COURS-YNOV/Projet-2-Carte-de-developpement-ESP32/Altium/ESP32_Project/com_.rtf

https://www.mouser.fr/datasheet/2/268/MCHP_S_A0010728890_1-2521060.pdf

MCP73831T-3ACI/OT
579-MCP73831T-3ACIOT

https://www.mouser.fr/ProductDetail/Microchip-Technology/MCP73831T-3ACI-OT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

—————————————————————————————————

https://www.digikey.fr/en/products/detail/CP2104-F03-GM/336-2008-5-ND/2486177?curr=usd
CP2104-F03-GM

—————————————————————————————————

https://www.mouser.fr/ProductDetail/AP-Memory/APS1604M-3SQR-SN?qs=IS%252B4QmGtzzpULD7HVv5Qww%3D%3D

PSRAM
