COURS-YNOV/Projet-2-Carte-de-developpement-ESP32/Altium/ESP32_Project/Project Outputs for ESP32_Projet/ESP32_Projet.xlsx

PN | Description | Comment | Designator | Fabricant | PN_Fab | Package | Footprint | Qualif | Temp | Tol | Volt | Puissance | Quantity | Lien
not use | Antennes Compact Reach Xtend 2.4 GHz | NN01-102 | B200 | Ignion | NN01-102 |  |  |  |  |  |  |  | 1 | https://www.mouser.fr/ProductDetail/Ignion/NN01-102?qs=bAKSY%2FctAC74AFavC%252BjOHQ%3D%3D
not use | Capacitor | 1uF | C100, C102, C104, C107, C201, C203, C204 | Murata Electronics | GRM155R61E105MA12D | 0402 |  |  |  | 20% |  |  | 7 | https://www.mouser.fr/ProductDetail/Murata-Electronics/GRM155R61E105MA12D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
not use | Capacitor | 0.1uF | C101, C103, C110 | Murata Electronics | GRM155R61C104KA88J | 0402 |  |  |  | 10% |  |  | 3 | https://www.mouser.fr/ProductDetail/Murata-Electronics/GRM155R61C104KA88J?qs=EsazKz6kkP2%252B3xHQUDEZoQ%3D%3D
not use | Capacitor | 1nF | C105 | Murata Electronics | GRT1555C1H102FA02D | 0402 |  |  |  | 1% |  |  | 1 | https://www.mouser.fr/ProductDetail/Murata-Electronics/GRT1555C1H102FA02D?qs=hd1VzrDQEGi3r1G6fgepQQ%3D%3D
not use | Capacitor | 4.7uF | C106, C200, C202 | Murata Electronics | GRT155D70J475ME13J | 0402 |  |  |  | 20% |  |  | 3 | https://www.mouser.fr/ProductDetail/Murata-Electronics/GRT155D70J475ME13J?qs=ufv2HEpFn%252BTkPthWI9s3Gg%3D%3D
not use | Capacitor | 1.2pF | C108 | Murata Electronics | GRM1555C1E1R2CA01D | 0402 |  |  |  | 0.25 pF |  |  | 1 | https://www.mouser.fr/ProductDetail/Murata-Electronics/GRM1555C1E1R2CA01D?qs=ouTquLLW2S4mMqEzAZk5RA%3D%3D
not use | Capacitor | 1.5pF | C109 | Murata Electronics | GRM1555C1H1R5BA01D | 0402 |  |  |  | 0.1 pF |  |  | 1 | https://www.mouser.fr/ProductDetail/Murata-Electronics/GRM1555C1H1R5BA01D?qs=ouTquLLW2S54hC6WW3CPAw%3D%3D
not use | Red, Green, Blue (RGB) 624nm Red, 525nm Green, 470nm Blue LED Indication - Discrete 2V Red, 3.3V Green, 3.3V Blue 4-SMD, No Lead | 150121M153000 | D200 | Wurth Elektronik | 150121M153000 | 0805 (2012 metric) |  |  |  |  |  |  | 1 | https://www.mouser.fr/ProductDetail/Wurth-Elektronik/150121M153000?qs=5aG0NVq1C4yYowchNNQhtg%3D%3D
not use | TVS Diode Array WE-TVS, High Speed Series - Low capazity - No leakage current - Low clamping voltage - high ESD voltage protection -- USB 1.0 - 2.0 | 824011 | D201 | Wurth Elektronik | 824011 | SOT-23-5 |  |  |  |  |  |  | 1 | https://www.mouser.fr/ProductDetail/Wurth-Elektronik/824011?qs=Wn16VcyqZWrHR48Vn%2FB8%252Bg%3D%3D
not use | Diode Array 3 Independent Schottky 40V 175mA Surface Mount 6-TSSOP, SC-88, SOT-363 | SD103AWS-7-F | DARR200 | Diodes Incorporated | SD103AWS-7-F | SOD-323-2 |  |  |  |  |  |  | 1 | https://www.mouser.fr/ProductDetail/Diodes-Incorporated/SD103AWS-7-F?qs=yDXQ%2Fb33kn1tCz%252Bb09bzhg%3D%3D
not use | Connecteurs USB USB Type C, 2.0, Rec, TH , G/F, RA , Top Mnt, T & R | USB4085-GF-A | J200 | GCT | USB4085-GF-A | 0402 |  |  |  |  |  |  | 1 | https://www.mouser.fr/ProductDetail/GCT/USB4085-GF-A?qs=KUoIvG%2F9Ilba1bQOahfWjw%3D%3D
not use | Conn Unshrouded Header HDR 10 POS 2.54mm Solder ST Thru-Hole Carton | TE_1-826629-0 | J201, J202 | TE Connectivity | TE_1-826629-0 | 0402 |  |  |  |  |  |  | 2 | https://www.mouser.fr/ProductDetail/TE-Connectivity/1-826629-0?qs=FazuUmncXom0aPLI6ZgGxg%3D%3D
not use | WURTH ELEKTRONIK - 61300211121 - HEADER, 2.54MM, PIN, THT, VERTICAL, 2WAY | 61300211121 | J203 | Wurth Elektronik | 61300211121 | 0402 |  |  |  |  |  |  | 1 | https://www.mouser.fr/ProductDetail/Wurth-Elektronik/61300211121?qs=t4813l51qx%252B1A5GYDQxPlw%3D%3D
not use | Bobine | 1.8nH | L100 | Murata Electronics | LQG15HH1N8S02D | 0402 |  |  |  | 0.3 nH |  |  | 1 | https://www.mouser.fr/ProductDetail/Murata-Electronics/LQG15HH1N8S02D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
not use | Bobines / filtres en mode commun WE-CNSW 1206 370mA 90Ohm 100MHz AECQ200 | 744232090 | L200 | Wurth Elektronik | 744232090 | 1206 (3216 metric) |  |  |  |  |  |  | 1 | https://www.mouser.fr/ProductDetail/Wurth-Elektronik/744232090?qs=PGXP4M47uW6L5fAiLO6yTw%3D%3D
not use | Bipolar Transistors - BJT NPN TRANSISTOR 1.5A 40V | SS8050-G | Q100, Q101 | Comchip Technology | SS8050-G | SOT-23-3 |  |  |  |  |  |  | 2 | https://www.mouser.fr/ProductDetail/Comchip-Technology/SS8050-G?qs=LLUE9lz1YbcHg%252BWLMAtcrQ%3D%3D
not use | MOSFET P-Channel MOSFET | SI3139K-TP | Q102, Q200 | Micro Commercial Components (MCC) | SI3139K-TP | SOT-723-3 |  |  |  |  |  |  | 2 | https://www.mouser.fr/ProductDetail/Micro-Commercial-Components-MCC/SI3139K-TP?qs=MoCBKJu1Jj02PHzM5h1rLQ%3D%3D
not use | BSS123 N-Channel MOSFET, 170 mA, 100 V PowerTrench, 3-Pin SOT-23 ON Semiconductor | BSS123 | Q103 | onsemi / Fairchild | BSS123 | SOT-23-3 |  |  |  |  |  |  | 1 | https://www.mouser.fr/ProductDetail/onsemi-Fairchild/BSS123?qs=FOlmdCx%252BAA2Kf8SEB3qLYA%3D%3D
not use | Resistor | 4.7K | R100 | TE Connectivity / Holsworthy | CRGCQ0402J4R7 | 0402 |  |  |  | 5% |  |  | 1 | https://www.mouser.fr/ProductDetail/TE-Connectivity-Holsworthy/CRGCQ0402J4R7
not use | Resistor | 10K | R101, R102, R104, R204 | TE Connectivity / Holsworthy | RN73C1E10KBTD | 0402 |  |  |  | 0.1% |  |  | 4 | https://www.mouser.fr/ProductDetail/TE-Connectivity-Holsworthy/RN73C1E10KBTD
not use | Resistor | 510R | R103 | TE Connectivity / Holsworthy | CRG0402F510R | 0402 |  |  |  | 1% |  |  | 1 | https://www.mouser.fr/ProductDetail/TE-Connectivity-Holsworthy/CRG0402F510R
not use | Resistor | 100K | R105, R106, R107, R200, R205 | TE Connectivity / Holsworthy | CPF0402B100KE | 0402 |  |  |  | 0.1% |  |  | 5 | https://www.mouser.fr/ProductDetail/TE-Connectivity-Holsworthy/CPF0402B100KE
not use | Resistor | 5K1 | R201, R203 | TE Connectivity / Holsworthy | CRG0402F5K1 | 0402 |  |  |  | 1% |  |  | 2 | https://www.mouser.fr/ProductDetail/TE-Connectivity-Holsworthy/CRG0402F5K1
not use | Resistor | 470R | R202 | TE Connectivity / Holsworthy | CRG0402F470R | 0402 |  |  |  | 1% |  |  | 1 | https://www.mouser.fr/ProductDetail/TE-Connectivity-Holsworthy/CRG0402F470R
not use | Système RF sur puce - SoC SIP module ESP32 with 4MByte Flash, Dual Core MCU, Wi-Fi & Bluetooth Combo, LGA48-pin, 7*7mm | ESP32-PICO-D4 | U100 | Espressif Systems | ESP32-PICO-D4 | QFN-48 |  |  |  |  |  |  | 1 | https://www.mouser.fr/ProductDetail/Espressif-Systems/ESP32-PICO-D4?qs=MLItCLRbWsw7MJlbN3HfdA%3D%3D
not use | USB Bridge, USB to UART USB 2.0 UART Interface 24-QFN (4x4) | CP2104-F03-GM | U101 | Silicon Labs | CP2104-F03-GM | QFN-24 |  |  |  |  |  |  | 1 | https://www.mouser.fr/ProductDetail/GCT/USB4085-GF-A?qs=KUoIvG%2F9Ilba1bQOahfWjw%3D%3D
not use | SRAM 8Mb, SerialRAM, 2.7V-3.6V, 104MHz, 8 pin SOIC 150 mil, RoHS | IS66WVS1M8BLL-104NLI | U102 | ISSI | IS66WVS1M8BLL-104NLI | SOIC-8 |  |  |  |  |  |  | 1 | https://www.mouser.fr/ProductDetail/ISSI/IS66WVS1M8BLL-104NLI?qs=doiCPypUmgGxZh5L3cgVoQ%3D%3D
not use | Gestion de batterie/pile Charge mgnt contr | MCP73831T-3ACI/OT | U200 | Microchip Technology | MCP73831T-3ACI/OT | SOT-23-5 |  |  |  |  |  |  | 1 | https://www.mouser.fr/ProductDetail/Microchip-Technology/MCP73831T-3ACI-OT?qs=yUQqVecv4quInAWkk8YFWg%3D%3D
not use | Régulateurs de tension LDO LDO 700 MA ULTRA-LOW NOISE 3.3V | NCP167BMX330TBG | U201 | onsemi | NCP167BMX330TBG | XDFN-4 |  |  |  |  |  |  | 1 | https://www.mouser.fr/ProductDetail/onsemi/NCP167BMX330TBG?qs=MLItCLRbWsxdhppZpZlnwg%3D%3D
not use | Black Tactile Tactile Switch, NO 50 mA 0.5mm Surface Mount | 430481025816 | X100 | Wurth Elektronik | 430481025816 |  |  |  |  |  |  |  | 1 | https://www.mouser.fr/ProductDetail/Wurth-Elektronik/430481025816?qs=wr8lucFkNMXXxhyqbLxcbg%3D%3D
