COURS-YNOV/Projet-2-Carte-de-developpement-ESP32/Altium/3d/2N7002KT1G/2N7002KT1G.stp

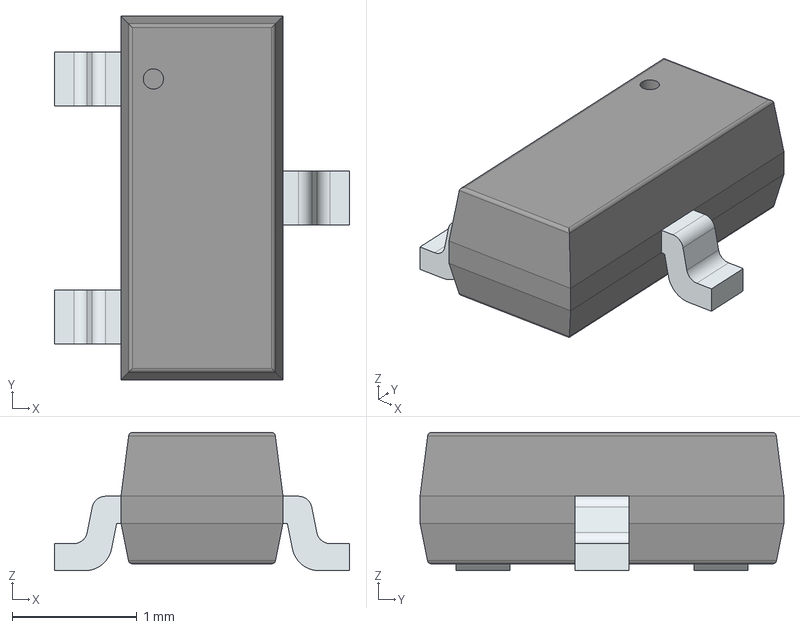
[picture p24: CAD file, 2024-12-17]
Altium/3d/2N7002KT1G/2N7002KT1G.stp
2.37 x 2.92 x 1.11 mm
PinsArrayL
FilletPinR
