COURS-YNOV/Projet-2-Carte-de-developpement-ESP32/Altium/3d/598-8610-207F/598-8610-207F.stp

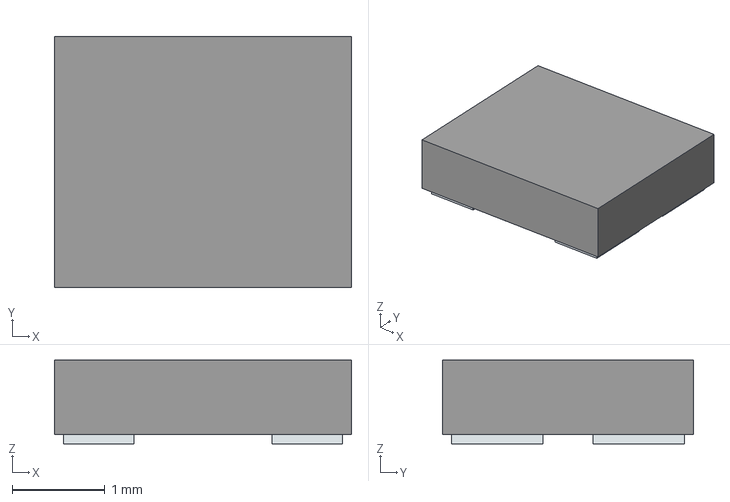
[picture p25: CAD file, 2024-12-17]
Altium/3d/598-8610-207F/598-8610-207F.stp
3.20 x 2.70 x 0.9 mm
Pins
