COURS-YNOV/Projet-2-Carte-de-developpement-ESP32/Altium/3d/74VHC05FT/74VHC05FT.stp

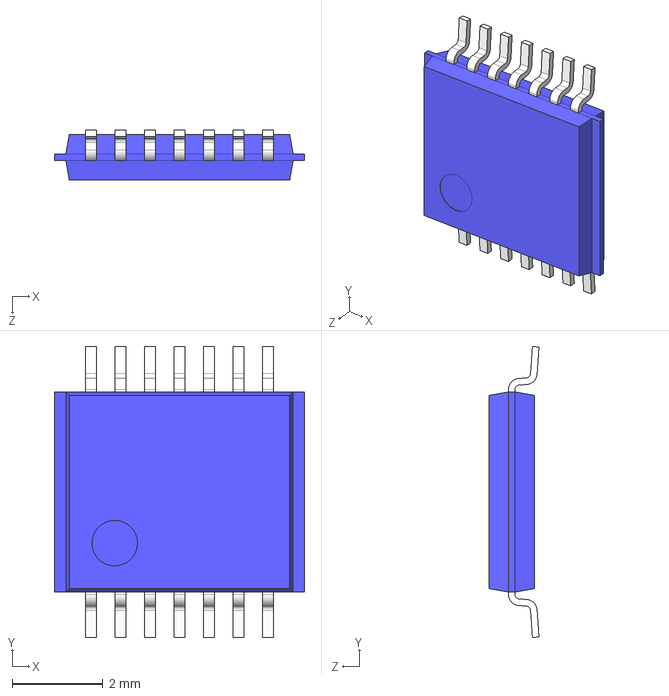
[picture p26: CAD file, 2024-12-17]
Altium/3d/74VHC05FT/74VHC05FT.stp
5.50 x 6.40 x 1.10 mm
