COURS-YNOV/Projet-2-Carte-de-developpement-ESP32/Altium/3d/CMT-8503-85B-SMT-TR/CMT-8503-85B-SMT-TR.stp

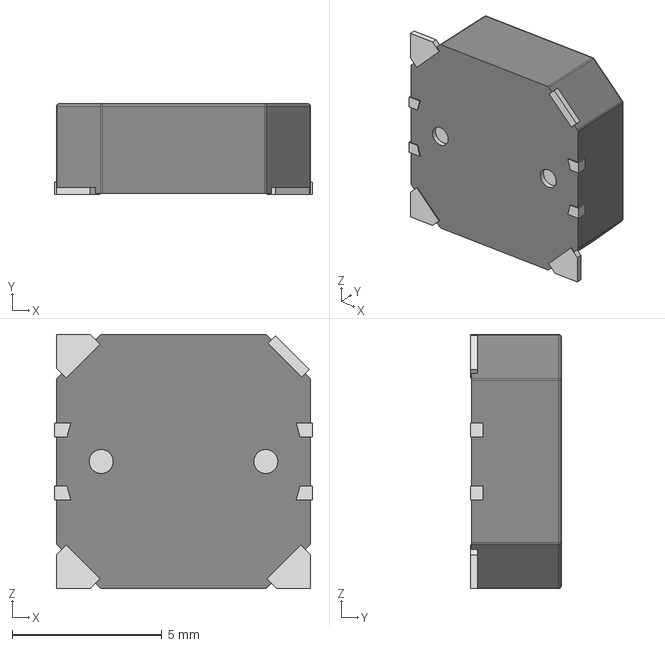
[picture p27: CAD file, 2024-12-17]
Altium/3d/CMT-8503-85B-SMT-TR/CMT-8503-85B-SMT-TR.stp
8.62 x 3.04 x 8.50 mm
