COURS-YNOV/Projet-2-Carte-de-developpement-ESP32/Altium/3d/FDV304P/FDV304P.stp

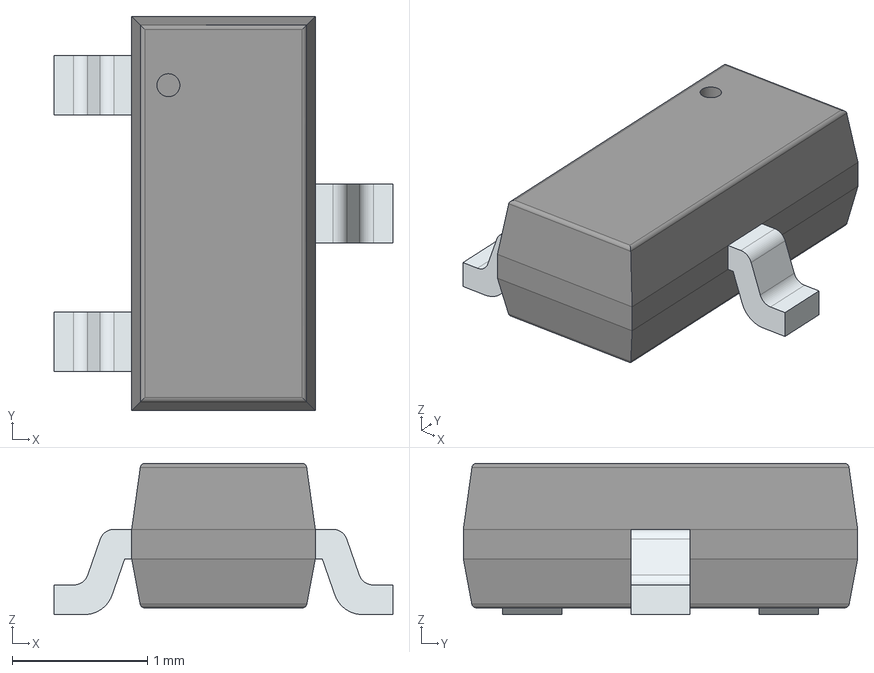
[picture p28: CAD file, 2024-12-17]
Altium/3d/FDV304P/FDV304P.stp
2.51 x 2.92 x 1.12 mm
PinsArrayL
FilletPinR
