COURS-YNOV/Projet-2-Carte-de-developpement-ESP32/Altium/3d/female-pitch-connector-2-54-mm-x8/2_54_x_8_pitch_connector_.STEP

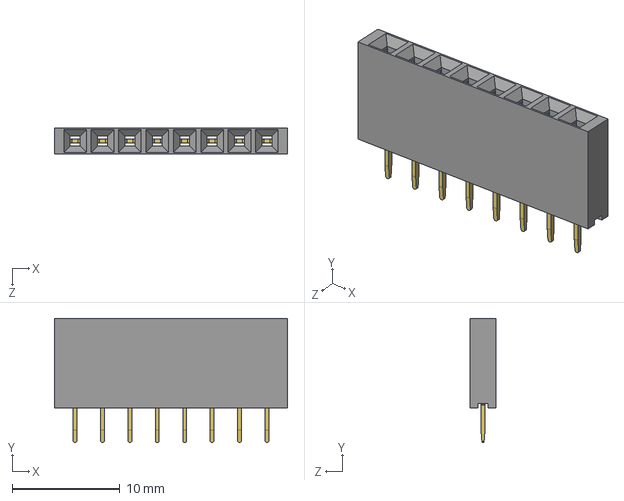
[picture p29: CAD file, 2024-12-17]
Altium/3d/female-pitch-connector-2-54-mm-x8/2_54_x_8_pitch_connector_.STEP
21.6 x 11.5 x 2.40 mm
Pitch_x_8
Plastic_x_8
