COURS-YNOV/Projet-2-Carte-de-developpement-ESP32/Altium/3d/INA237AIDGST/INA237AIDGST.stp

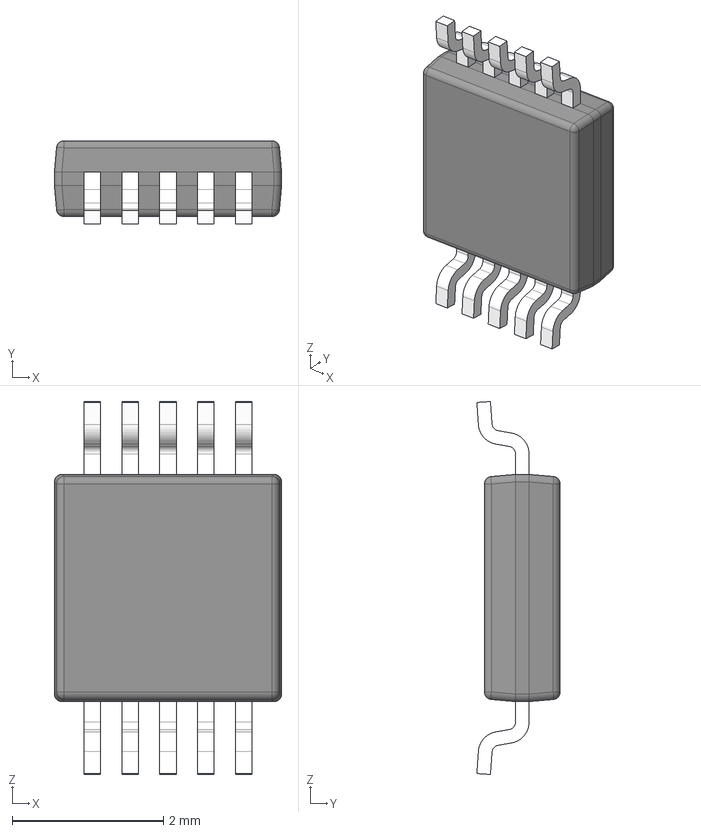
[picture p30: CAD file, 2024-12-17]
Altium/3d/INA237AIDGST/INA237AIDGST.stp
3.00 x 1.10 x 4.93 mm
BODY-SO
LEAD-SO x 10
PIN1-ID
