COURS-YNOV/Projet-2-Carte-de-developpement-ESP32/Altium/3d/MC74VHC1GT08DFT2G/MC74VHC1GT08DFT2G.stp

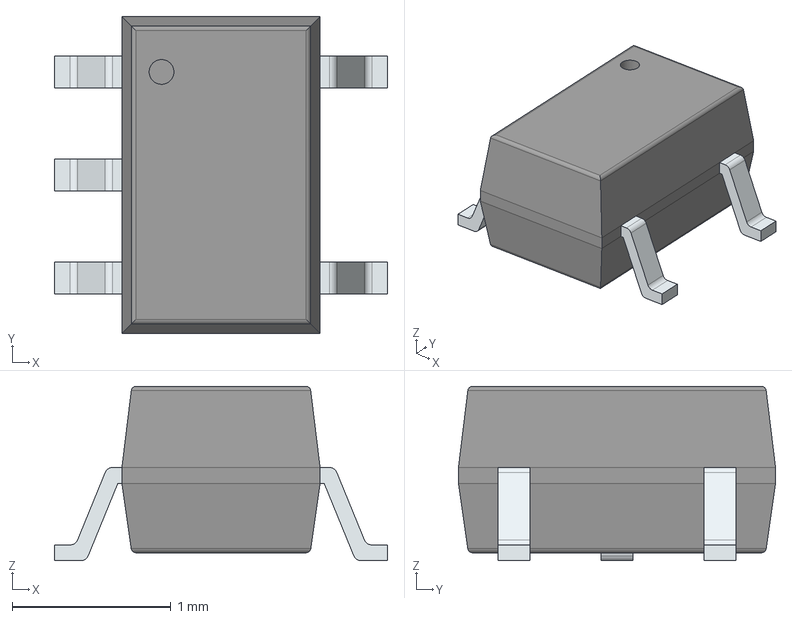
[picture p31: CAD file, 2024-12-17]
Altium/3d/MC74VHC1GT08DFT2G/MC74VHC1GT08DFT2G.stp
2.10 x 2.00 x 1.10 mm
PinsArrayL
PinsArrayR
