COURS-YNOV/Projet-2-Carte-de-developpement-ESP32/Altium/3d/NCP1117IST33T3G/NCP1117IST33T3G.stp

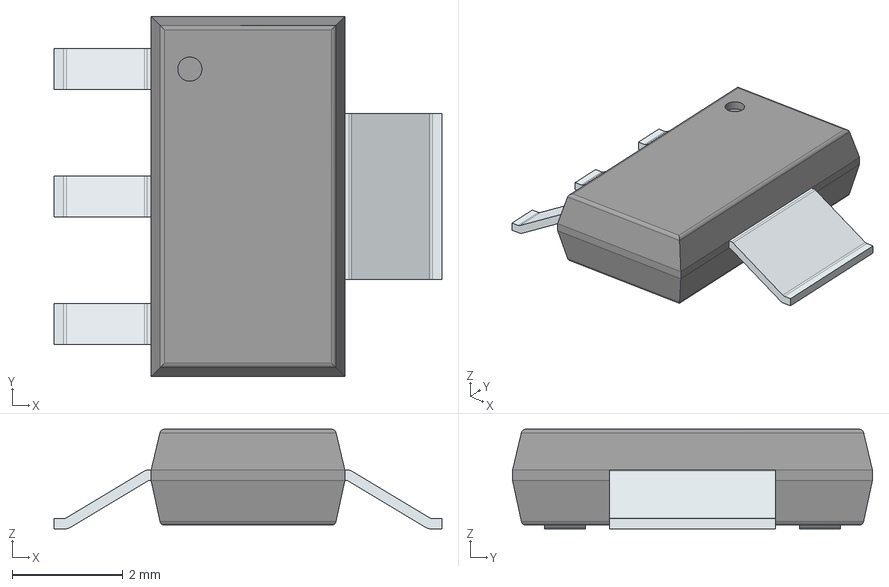
[picture p32: CAD file, 2024-12-17]
Altium/3d/NCP1117IST33T3G/NCP1117IST33T3G.stp
7.00 x 6.50 x 1.80 mm
PinsArrayL
FilletPinR
