COURS-YNOV/Projet-2-Carte-de-developpement-ESP32/Altium/3d/NCP167BMX330TBG/NCP167BMX330TBG.stp

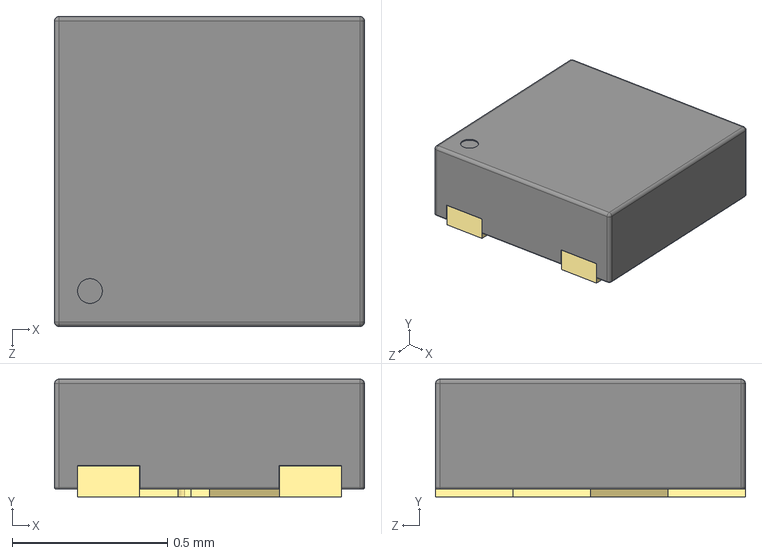
[picture p33: CAD file, 2024-12-17]
Altium/3d/NCP167BMX330TBG/NCP167BMX330TBG.stp
1.00 x 0.38 x 1.00 mm
