COURS-YNOV/Projet-2-Carte-de-developpement-ESP32/Altium/3d/NN01-102/NN01-102.step

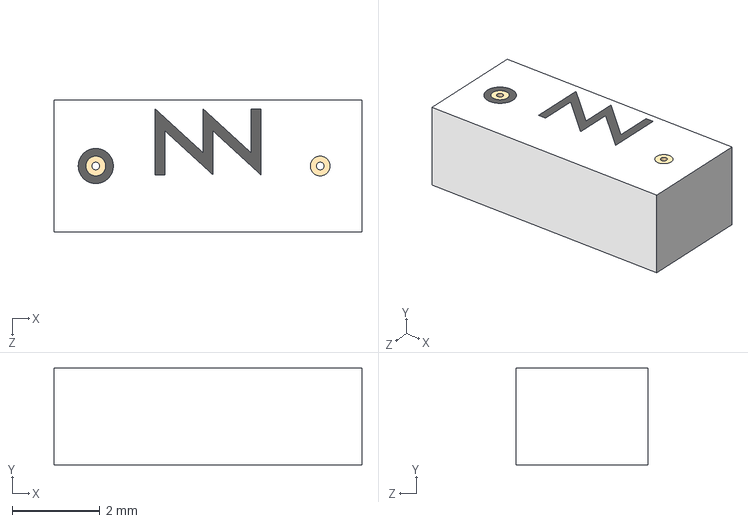
[picture p34: CAD file, 2024-12-17]
Altium/3d/NN01-102/NN01-102.step
7.00 x 2.20 x 3.00 mm
