COURS-YNOV/Projet-2-Carte-de-developpement-ESP32/Altium/3d/PSR400ITQFF0L50/PSR400ITQFF0L50.stp

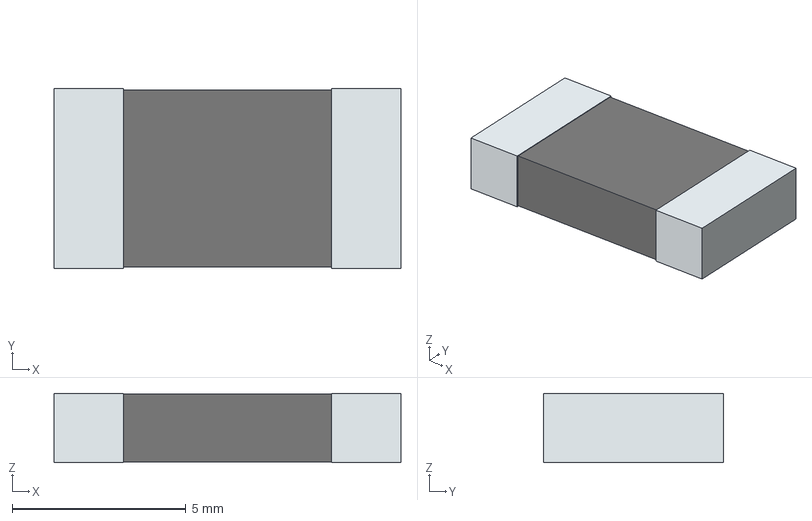
[picture p35: CAD file, 2024-12-17]
Altium/3d/PSR400ITQFF0L50/PSR400ITQFF0L50.stp
10.0 x 5.20 x 2.00 mm
term1
term2
