COURS-YNOV/Projet-2-Carte-de-developpement-ESP32/Altium/3d/TMP126DCKR/TMP126DCKR.stp

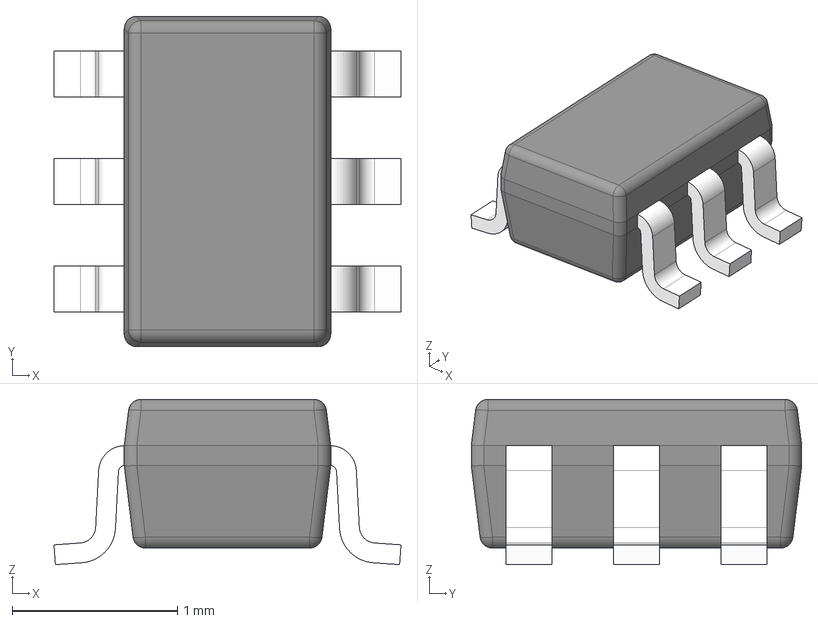
[picture p36: CAD file, 2024-12-17]
Altium/3d/TMP126DCKR/TMP126DCKR.stp
2.10 x 2.00 x 1.00 mm
BODY-SOT
LEAD-SOT x 6
PIN1-ID
