COURS-YNOV/Projet-2-Carte-de-developpement-ESP32/Altium/3d/114020164/114020164.stp

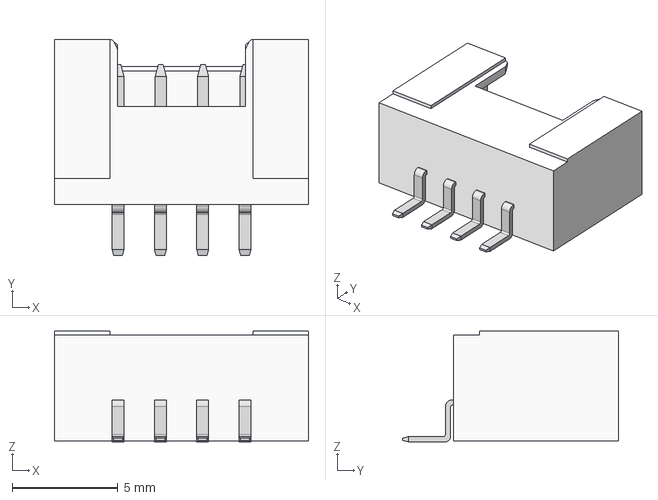
[picture p37: CAD file, 2024-12-17]
Altium/3d/114020164/114020164.stp
12.0 x 10.2 x 5.24 mm
