COURS-YNOV/Projet-2-Carte-de-developpement-ESP32/Altium/3d/430481025816/430481025816.stp

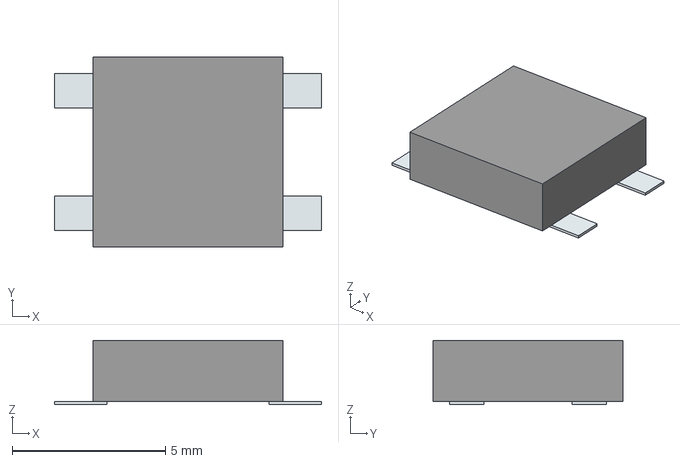
[picture p38: CAD file, 2024-12-17]
Altium/3d/430481025816/430481025816.stp
8.72 x 6.20 x 2.10 mm
Pins
