COURS-YNOV/Projet-2-Carte-de-developpement-ESP32/(list of files, cad)

Other CAD files:
Altium/3d/BSS123LT1G/BSS123LT1G.stp
Altium/3d/MC74VHC1GT32DFT1G/MC74VHC1GT32DFT1G.stp
Altium/3d/824011/824011.stp
Altium/3d/825433-8/825433-8.stp
Altium/3d/LMR50410Y3FQDBVRQ1/LMR50410Y3FQDBVRQ1.stp
