COURS-YNOV/Projet-2-Carte-de-developpement-ESP32/Altium/ESP32_Project/ESP32_Projet.pdf

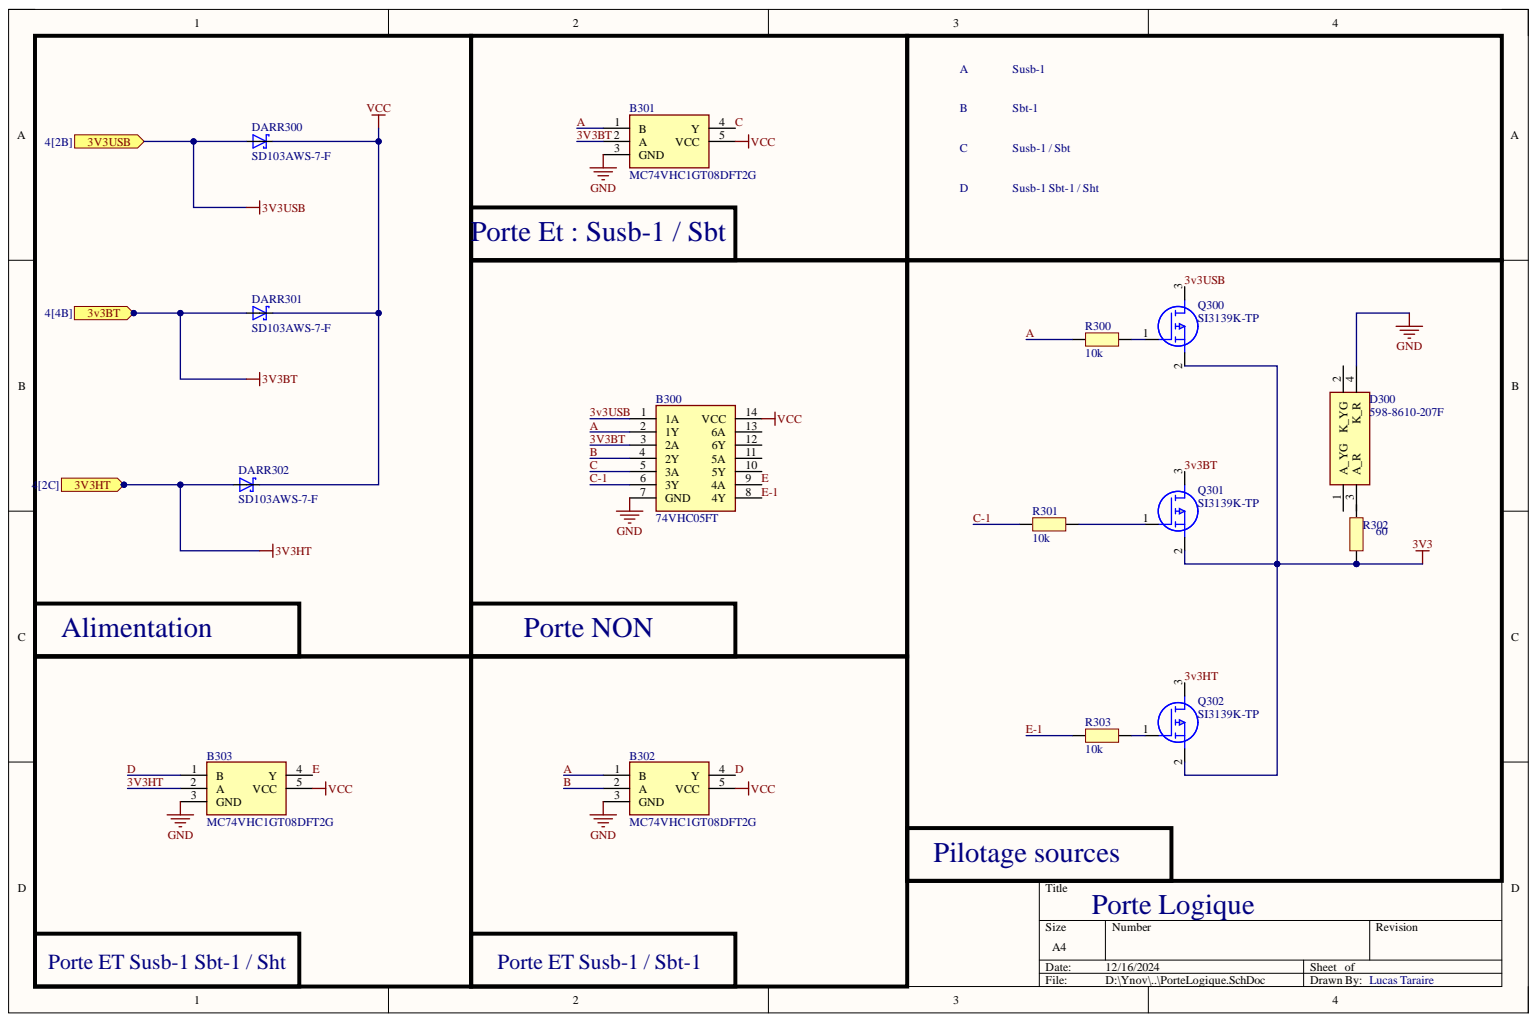
[picture p40: page 1]

Porte Et : Susb-1 / Sbt

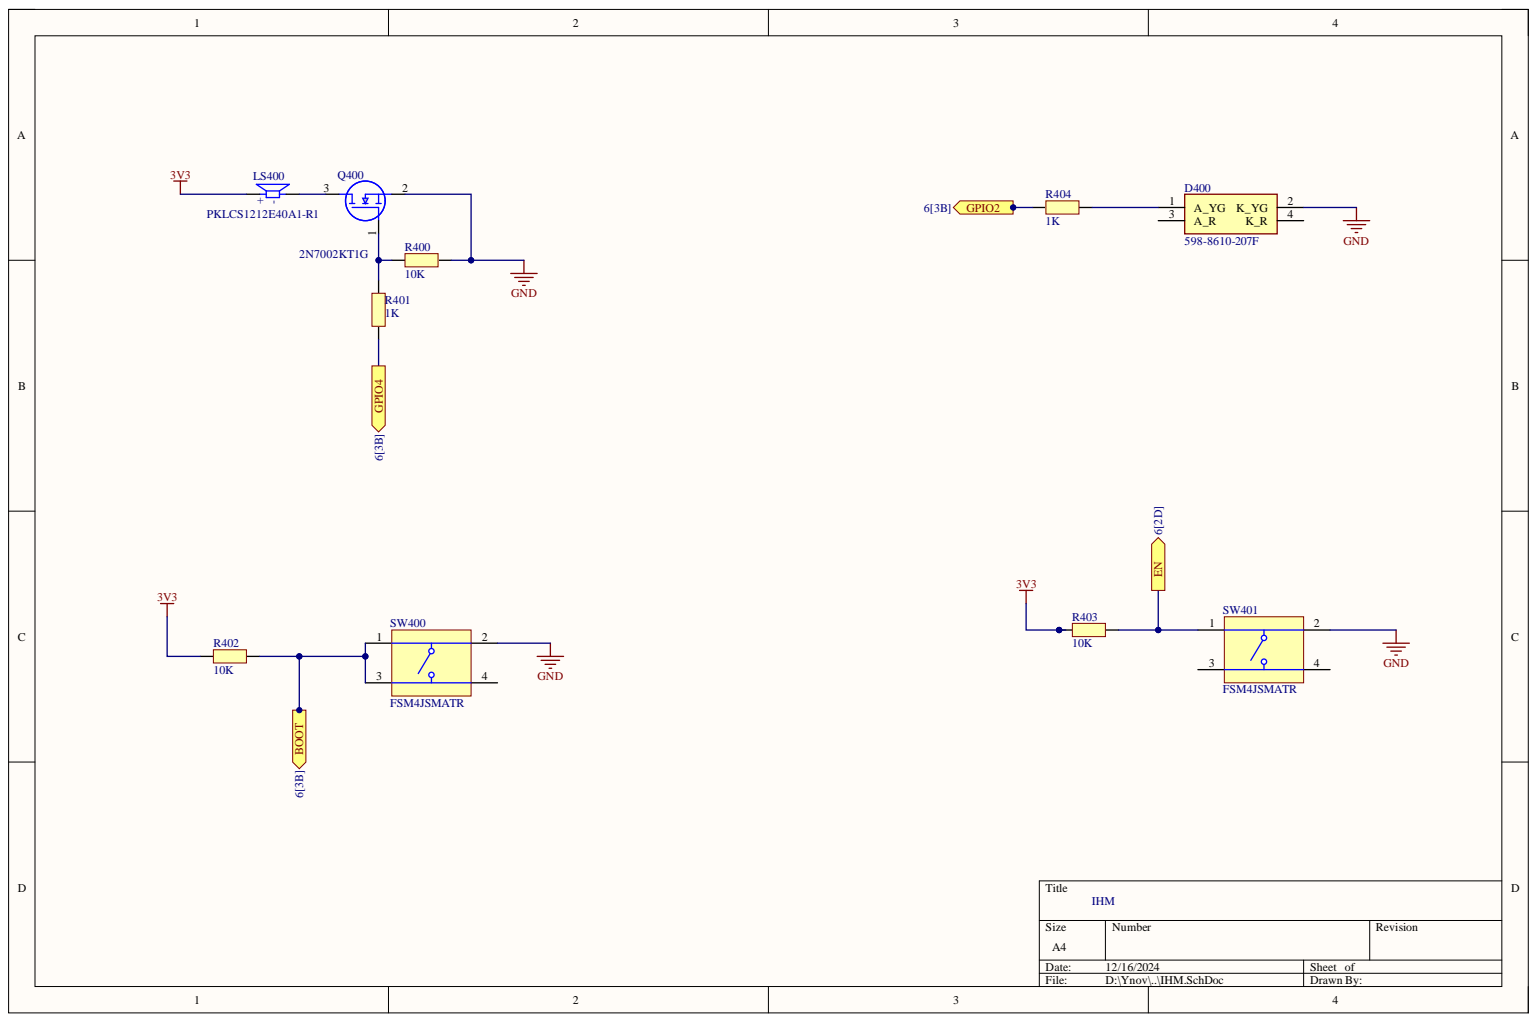
[picture p41: page 2]

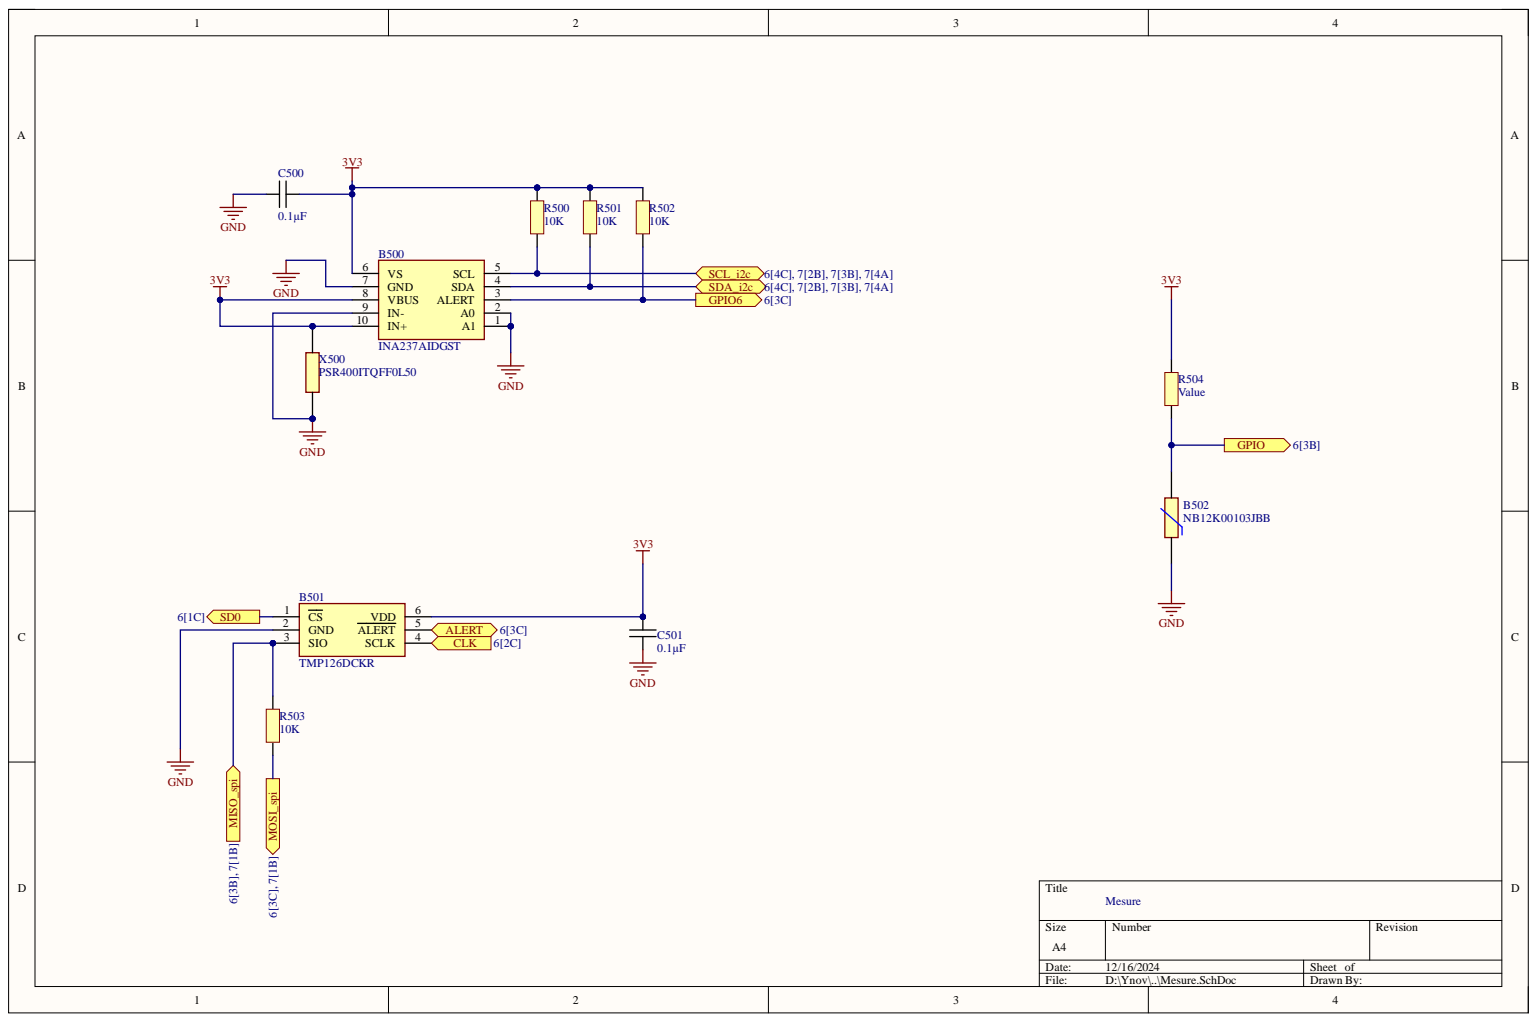
[picture p42: page 3]

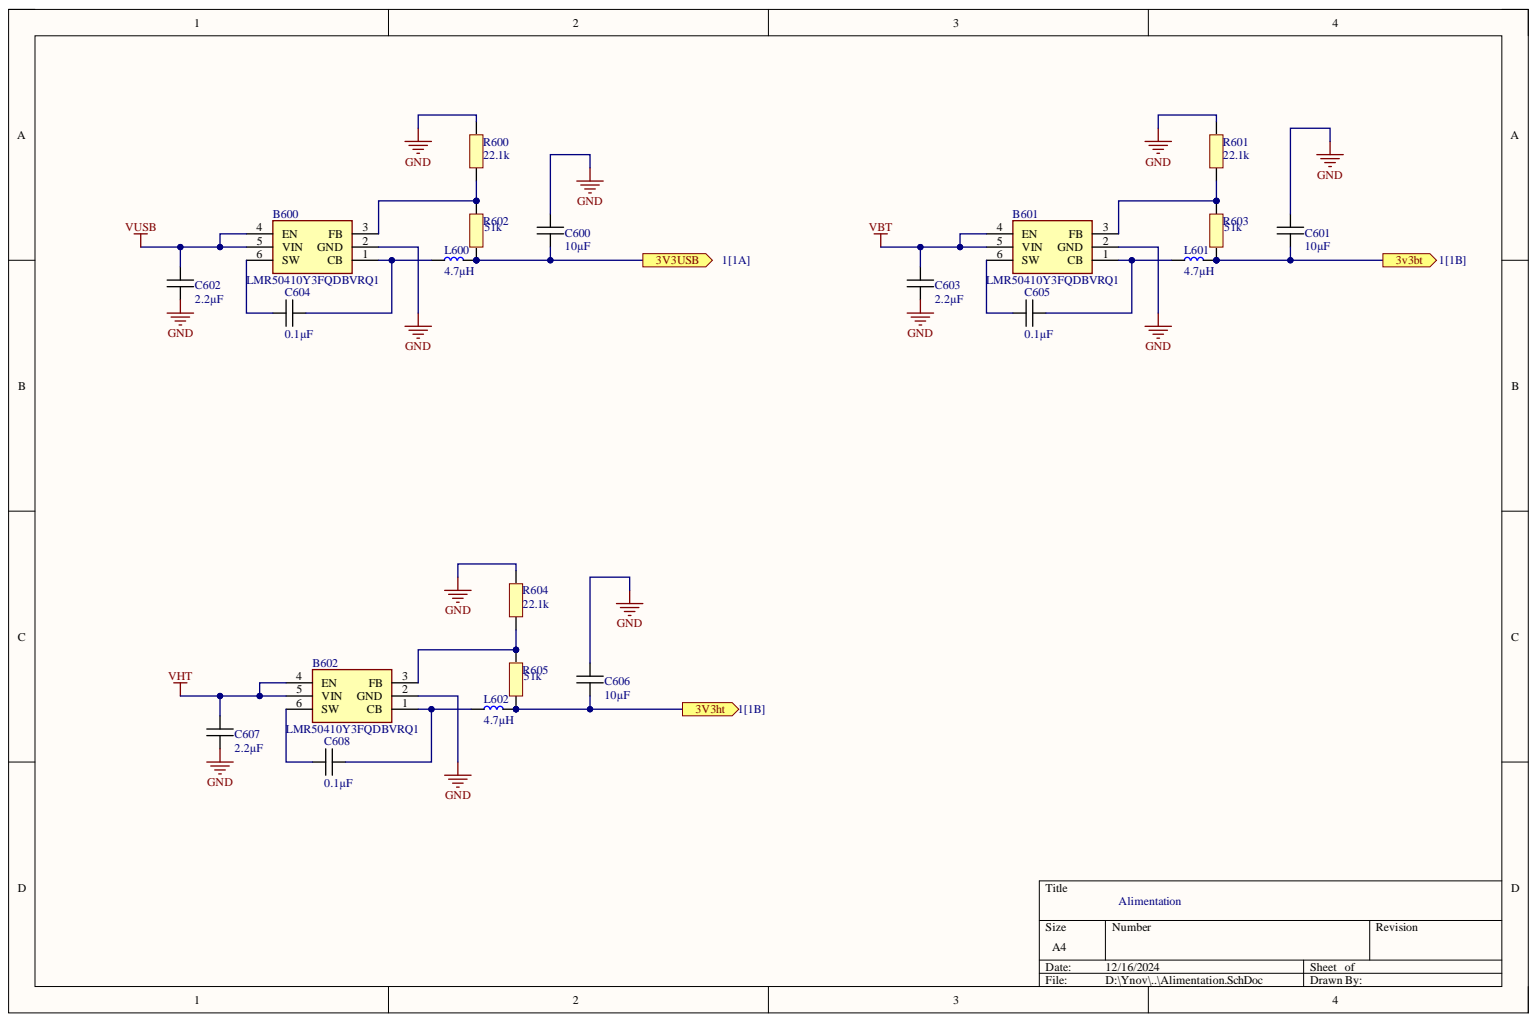
[picture p43: page 4]

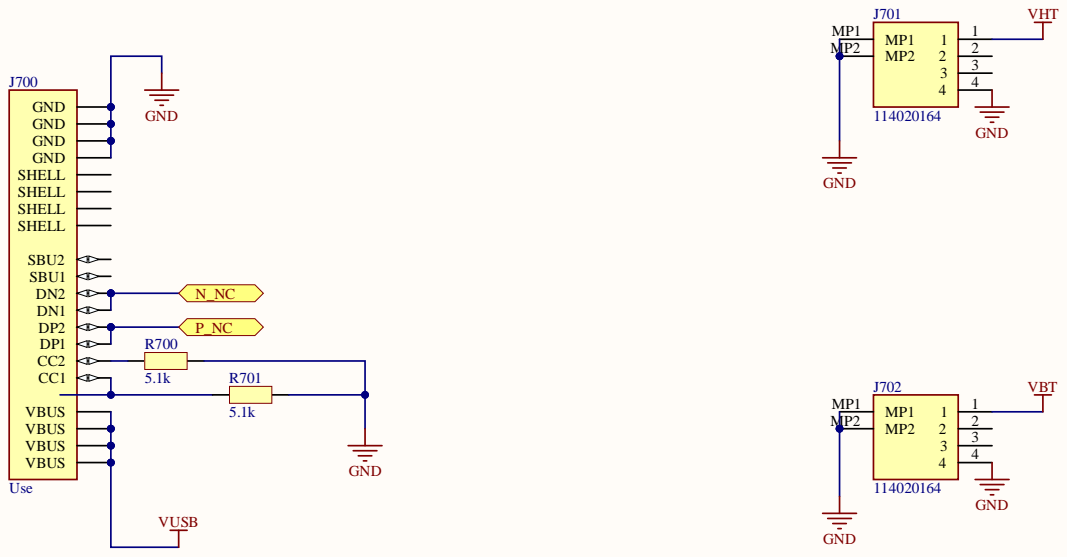
[picture p44: page 5]

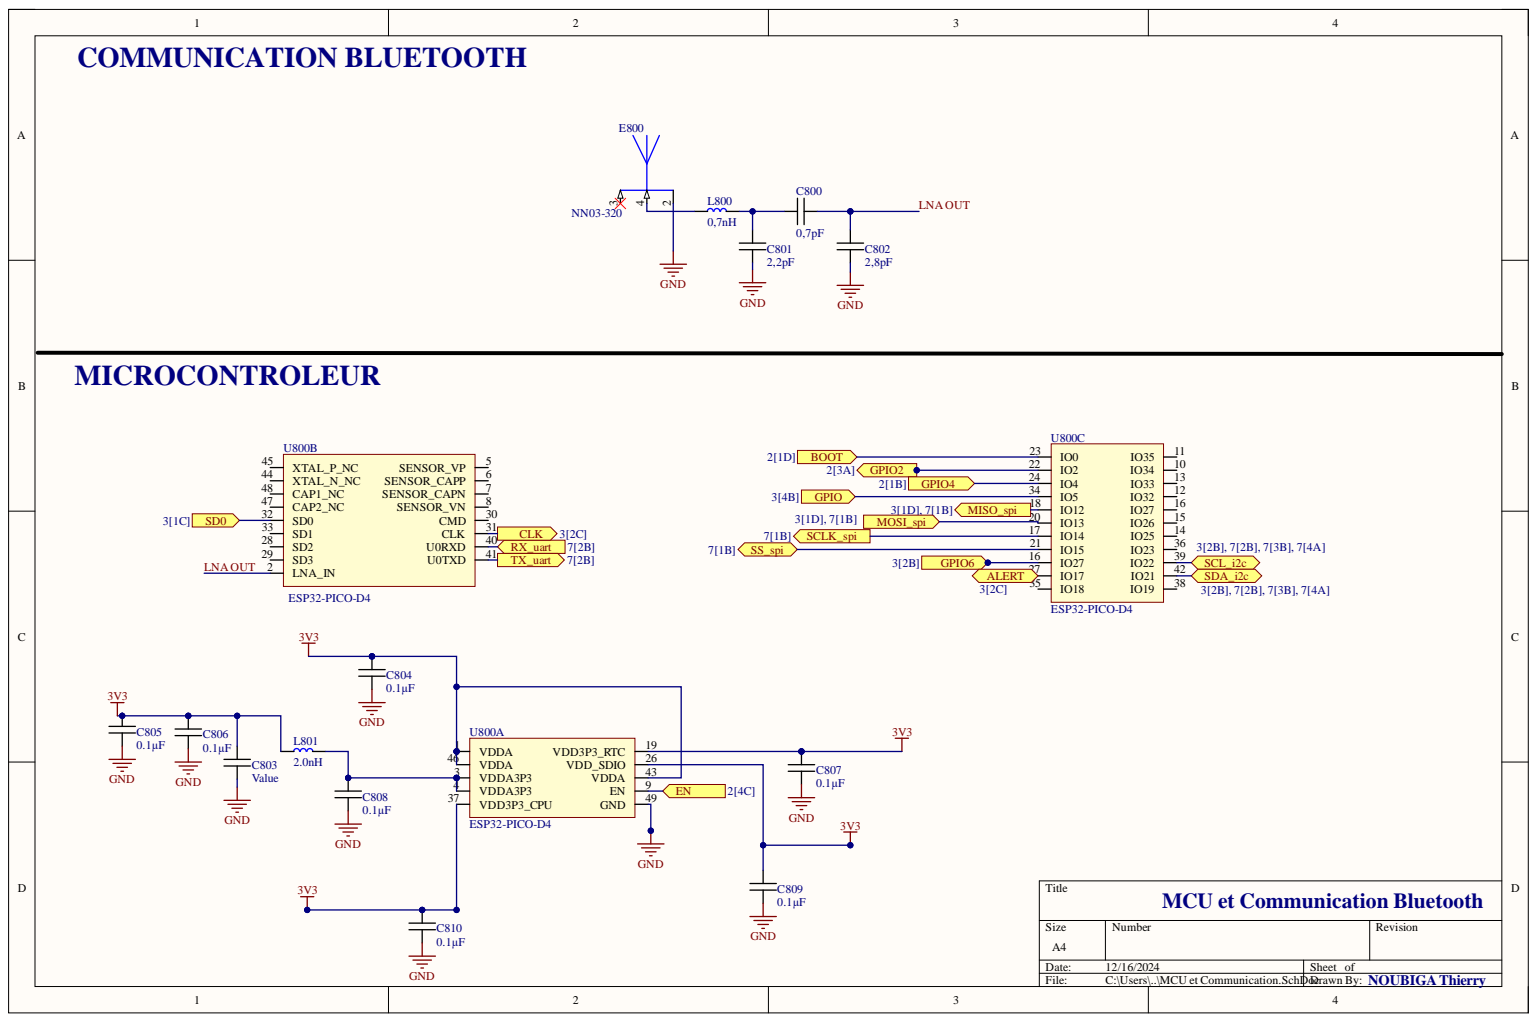
[picture p45: page 6]

MCU et Communication Bluetooth

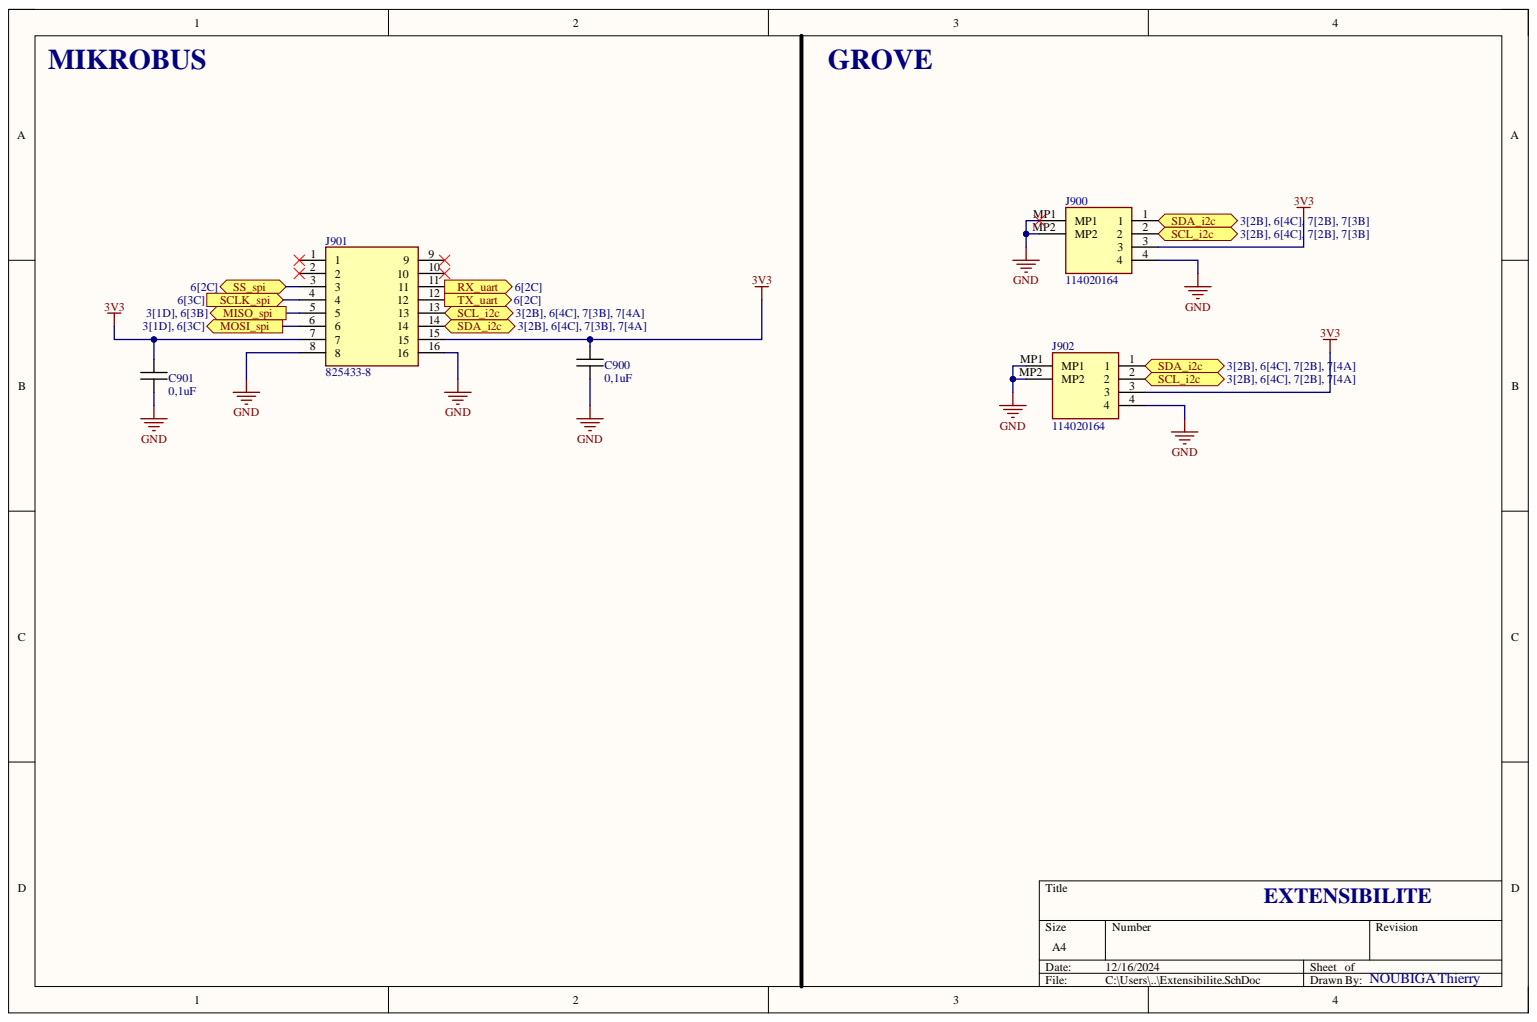
[picture p46: page 7]
