COURS-YNOV/Projet-2-Carte-de-developpement-ESP32/(list of files, drawings)

Other design files:
Altium/ESP32_Project/Alimentation.SchDoc
Altium/ESP32_Project/ESP32_Project/ESP32_Projet.PrjPcb
Altium/ESP32_Project/ESP32_Project/PCB1.PcbDoc
Altium/ESP32_Project/ESP32_Project/PCBLibrary.PcbLib
Altium/ESP32_Project/ESP32_Project/SCHLibrary.SchLib
Altium/ESP32_Project/ESP32_Project/Sheet1.SchDoc
Altium/ESP32_Project/ESP32_Projet.PrjPcb
Altium/ESP32_Project/Extensibilite.SchDoc
Altium/ESP32_Project/IHM.SchDoc
Altium/ESP32_Project/MCU et Communication.SchDoc
Altium/ESP32_Project/Mesure.SchDoc
Altium/ESP32_Project/PCB1.PcbDoc
Altium/ESP32_Project/PCBLibrary.PcbLib
Altium/ESP32_Project/PorteLogique.SchDoc
Altium/ESP32_Project/SCHLibrary.SchLib
Altium/ESP32_Project/Sources.SchDoc
